Thaarun23/Jerboa_robot_simulation/Final_sw_files/leg_mechanism_1_leg.SLDASM

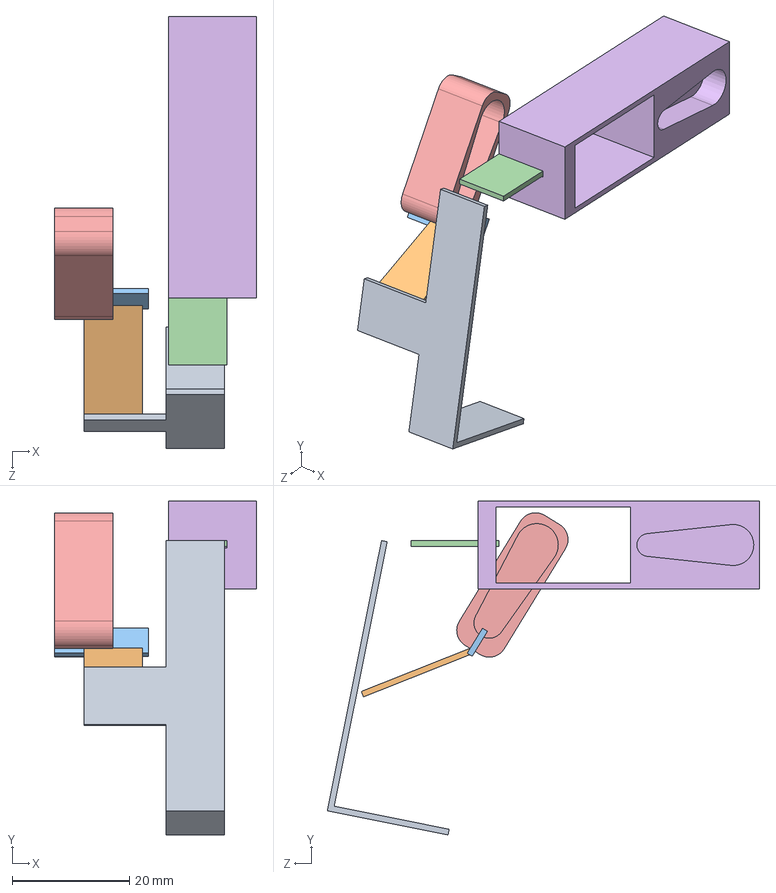
[picture p49: CAD file, 2025-03-19]
Final_sw_files/leg_mechanism_1_leg.SLDASM
34.5 x 57.0 x 73.7 mm
leg_1_ss
fitting_servo2
l1b_cut_2
l2l
l3l
l4f
