Thaarun23/Jerboa_robot_simulation/Final_sw_files/4bar_leg.SLDASM

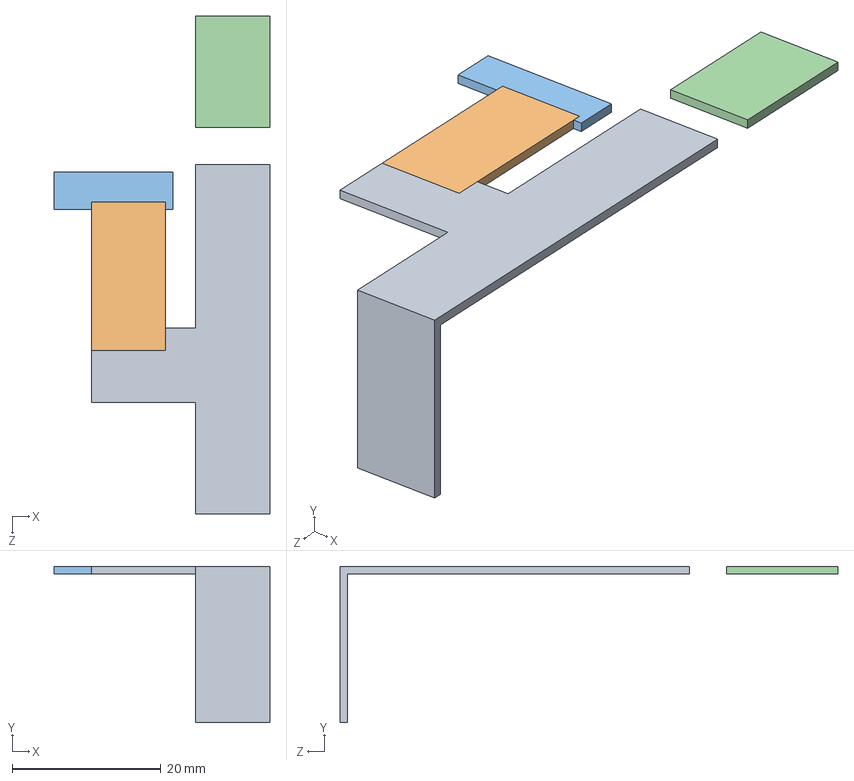
[picture p50: CAD file, 2025-03-19]
Final_sw_files/4bar_leg.SLDASM
29.0 x 21.0 x 67.0 mm
l1b_cut_2
l2l
l3l
l4f
