Thaarun23/Jerboa_robot_simulation/BODY CUT FILES FINAL/first_pass0.dxf

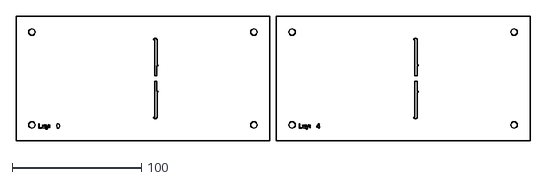
[picture p51: CAD file, 2025-03-19]
BODY CUT FILES FINAL/first_pass0.dxf
398.2 x 96.6
