Thaarun23/Jerboa_robot_simulation/LEG CUT FILES FINAL/final_cut2.dxf

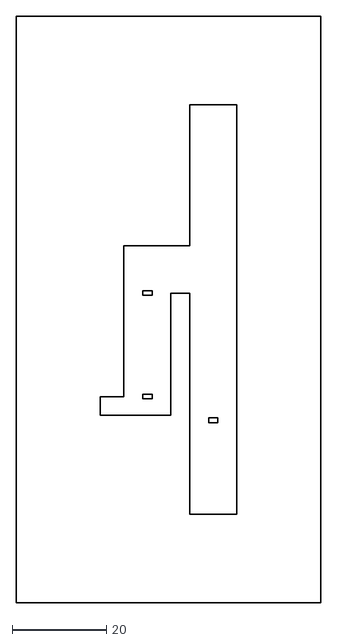
[picture p52: CAD file, 2025-03-19]
LEG CUT FILES FINAL/final_cut2.dxf
64.6 x 124.6
