Thaarun23/Jerboa_robot_simulation/leg_design_5.dxf

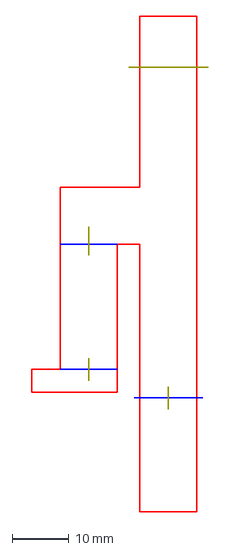
[picture p53: CAD file, 2025-03-19]
leg_design_5.dxf
31.0 x 87.0 mm
