Thaarun23/Jerboa_robot_simulation/BODY CUT FILES FINAL/first_pass2.dxf

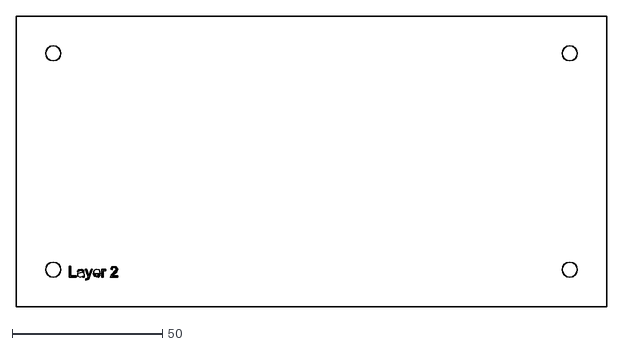
[picture p54: CAD file, 2025-03-19]
BODY CUT FILES FINAL/first_pass2.dxf
196.6 x 96.6
