Thaarun23/Jerboa_robot_simulation/body_tail_6.dxf

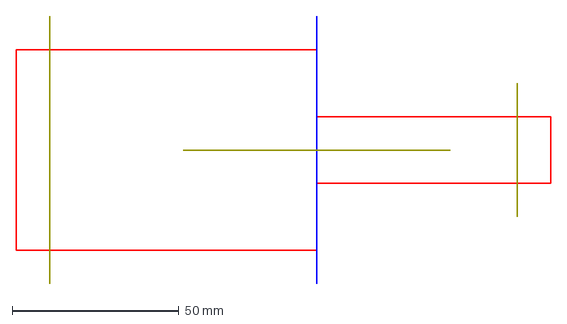
[picture p55: CAD file, 2025-03-19]
body_tail_6.dxf
160.0 x 80.0 mm
