Thaarun23/Jerboa_robot_simulation/LEG CUT FILES FINAL/first_pass2-2.dxf

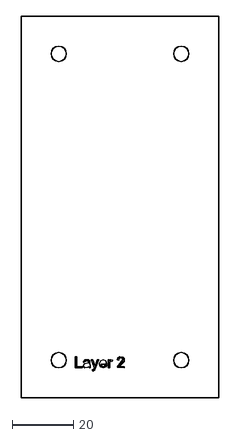
[picture p56: CAD file, 2025-03-19]
LEG CUT FILES FINAL/first_pass2-2.dxf
64.6 x 124.6
