Thaarun23/Jerboa_robot_simulation/BODY CUT FILES FINAL/first_pass1.dxf

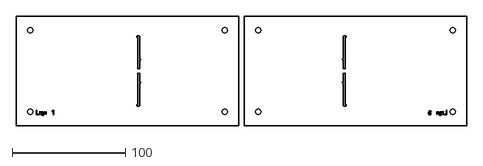
[picture p57: CAD file, 2025-03-19]
BODY CUT FILES FINAL/first_pass1.dxf
398.2 x 96.6
