Thaarun23/Jerboa_robot_simulation/Final_sw_files/l1b_cut.SLDPRT

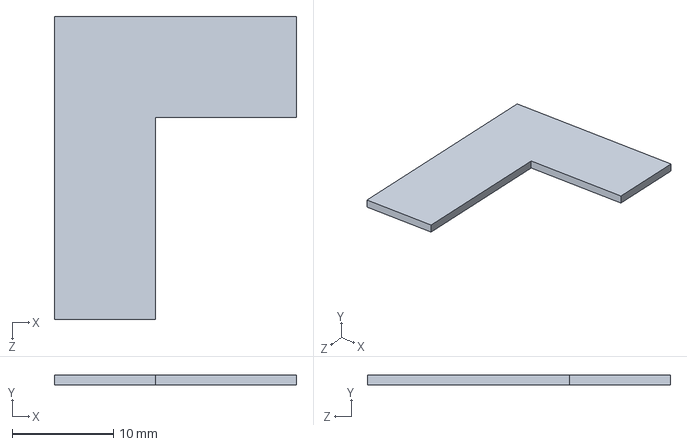
[picture p58: CAD file, 2025-03-19]
Final_sw_files/l1b_cut.SLDPRT
24.0 x 1.00 x 30.0 mm
