Thaarun23/Jerboa_robot_simulation/LEG CUT FILES FINAL/first_pass2.dxf

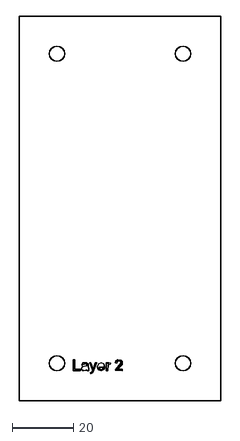
[picture p59: CAD file, 2025-03-19]
LEG CUT FILES FINAL/first_pass2.dxf
65.9 x 125.9
