Thaarun23/Jerboa_robot_simulation/BODY CUT FILES FINAL/first_pass2-2.dxf

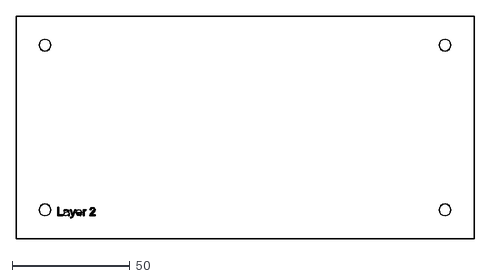
[picture p60: CAD file, 2025-03-19]
BODY CUT FILES FINAL/first_pass2-2.dxf
194.6 x 94.6
