Thaarun23/Jerboa_robot_simulation/Final_sw_files/l3l.SLDPRT

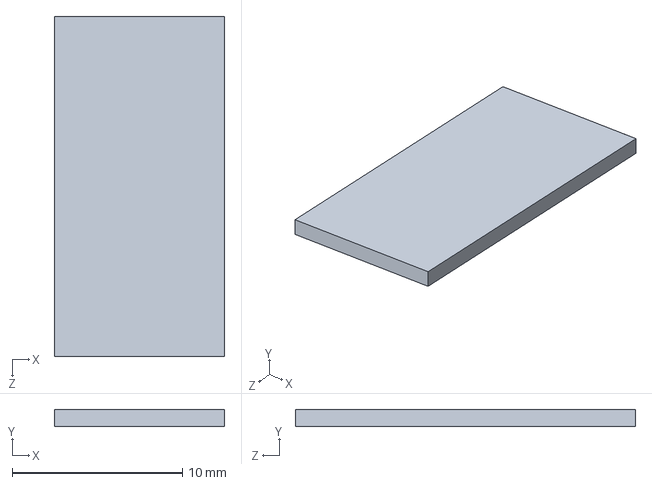
[picture p61: CAD file, 2025-03-19]
Final_sw_files/l3l.SLDPRT
10.0 x 1.00 x 20.0 mm
