Thaarun23/Jerboa_robot_simulation/BODY CUT FILES FINAL/final_cut2.dxf

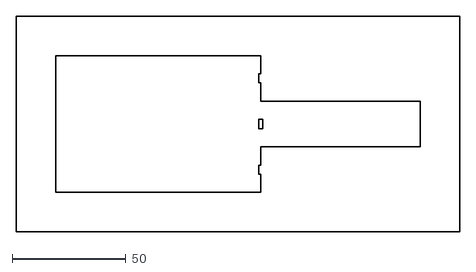
[picture p63: CAD file, 2025-03-19]
BODY CUT FILES FINAL/final_cut2.dxf
194.6 x 94.6
