Thaarun23/Jerboa_robot_simulation/LEG CUT FILES FINAL/final_cut.dxf

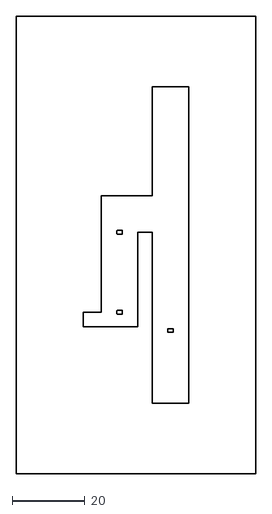
[picture p64: CAD file, 2025-03-19]
LEG CUT FILES FINAL/final_cut.dxf
65.9 x 125.9
