Thaarun23/Jerboa_robot_simulation/BODY CUT FILES FINAL/first_pass2-0.dxf

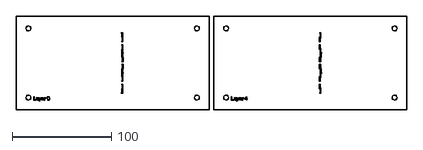
[picture p65: CAD file, 2025-03-19]
BODY CUT FILES FINAL/first_pass2-0.dxf
394.2 x 94.6
