Thaarun23/Jerboa_robot_simulation/Final_sw_files/l1b_cut_2.SLDPRT

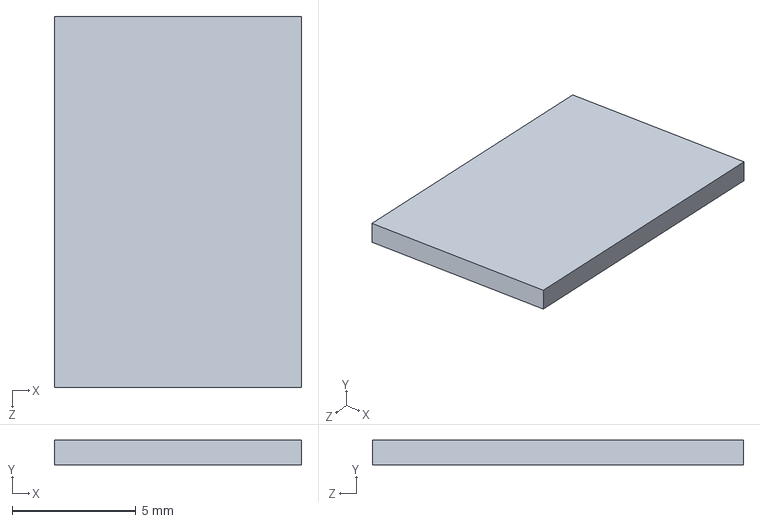
[picture p66: CAD file, 2025-03-19]
Final_sw_files/l1b_cut_2.SLDPRT
10.0 x 1.00 x 15.0 mm
