Thaarun23/Jerboa_robot_simulation/LEG CUT FILES FINAL/first_pass0.dxf

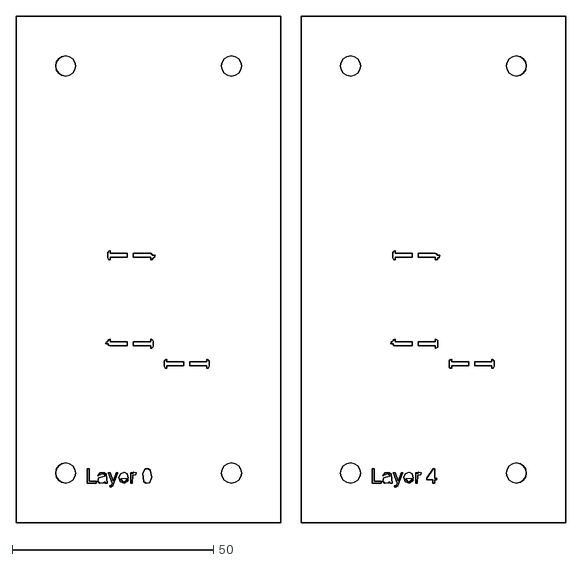
[picture p67: CAD file, 2025-03-19]
LEG CUT FILES FINAL/first_pass0.dxf
136.7 x 125.9
