Thaarun23/Jerboa_robot_simulation/BODY CUT FILES FINAL/final_cut.dxf

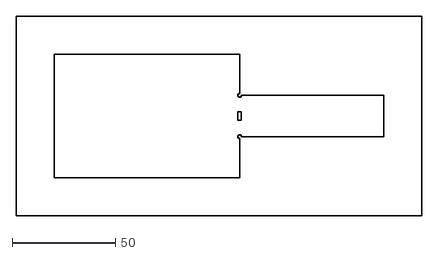
[picture p68: CAD file, 2025-03-19]
BODY CUT FILES FINAL/final_cut.dxf
196.6 x 96.6
