Thaarun23/Jerboa_robot_simulation/Final_sw_files/leg_1_ss.SLDPRT

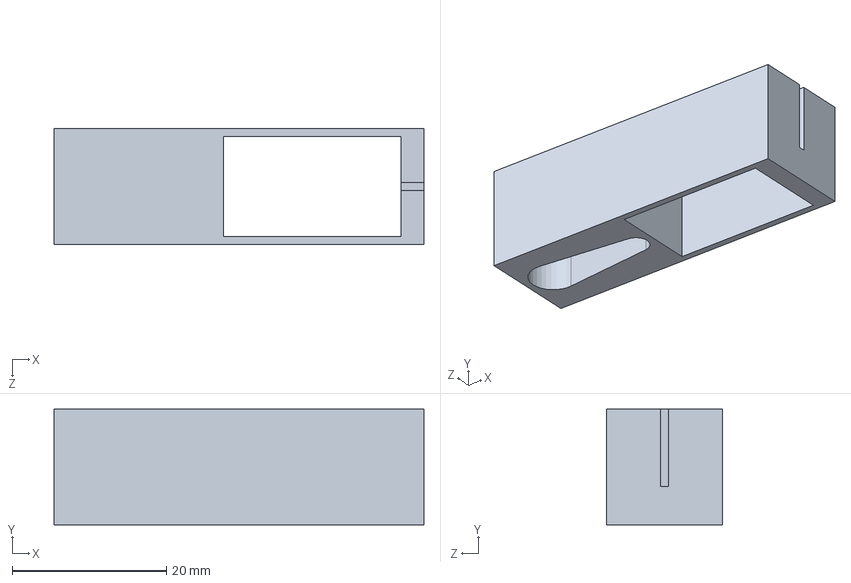
[picture p69: CAD file, 2025-03-19]
Final_sw_files/leg_1_ss.SLDPRT
48.0 x 15.0 x 15.0 mm
