Thaarun23/Jerboa_robot_simulation/LEG CUT FILES FINAL/first_pass2-0.dxf

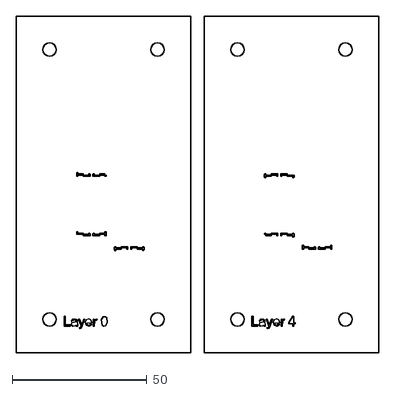
[picture p70: CAD file, 2025-03-19]
LEG CUT FILES FINAL/first_pass2-0.dxf
134.2 x 124.6
