Thaarun23/Jerboa_robot_simulation/Final_sw_files/l2l.SLDPRT

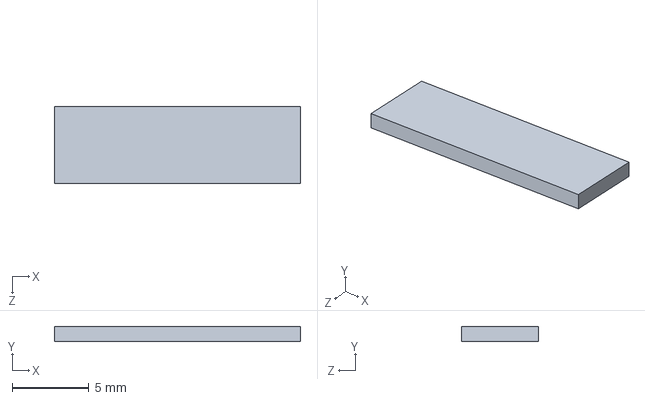
[picture p72: CAD file, 2025-03-19]
Final_sw_files/l2l.SLDPRT
16.0 x 1.00 x 5.00 mm
