Thaarun23/Jerboa_robot_simulation/Final_sw_files/base_link.SLDPRT

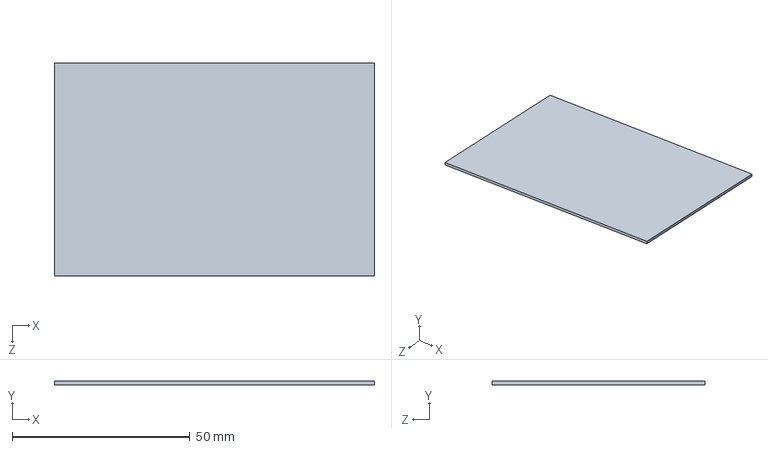
[picture p73: CAD file, 2025-03-19]
Final_sw_files/base_link.SLDPRT
90.0 x 1.00 x 60.0 mm
