Thaarun23/Jerboa_robot_simulation/LEG CUT FILES FINAL/first_pass1.dxf

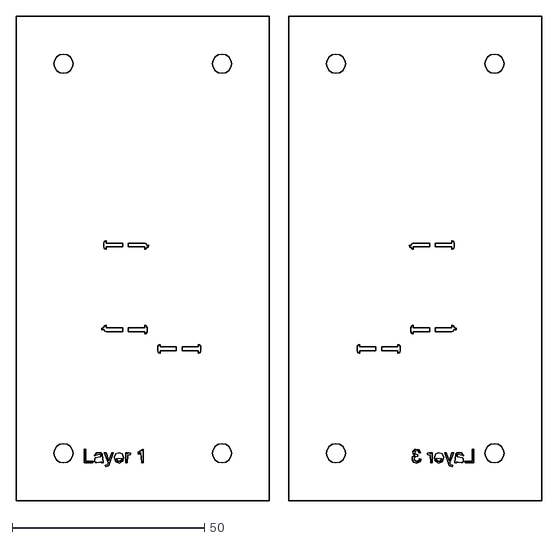
[picture p74: CAD file, 2025-03-19]
LEG CUT FILES FINAL/first_pass1.dxf
136.7 x 125.9
