Thaarun23/Jerboa_robot_simulation/Final_sw_files/fitting_servo2.SLDPRT

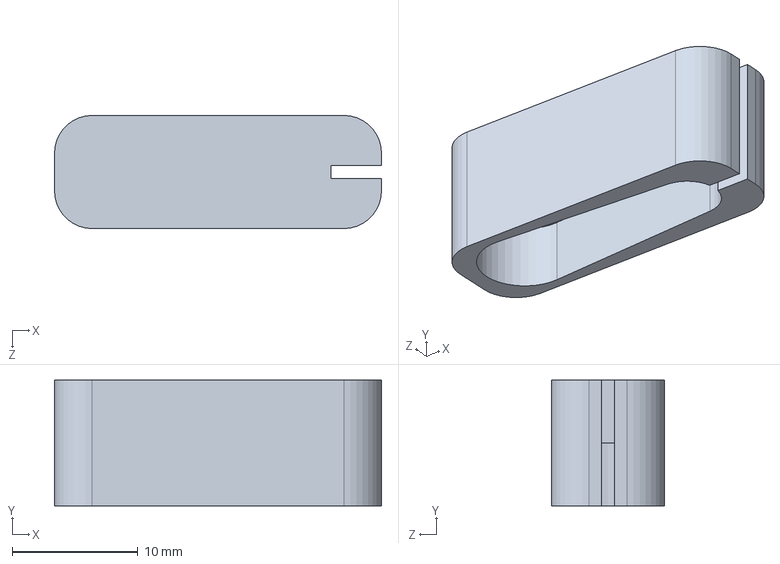
[picture p75: CAD file, 2025-03-19]
Final_sw_files/fitting_servo2.SLDPRT
26.0 x 10.0 x 9.00 mm
