Thaarun23/Jerboa_robot_simulation/Final_sw_files/l1b.SLDPRT

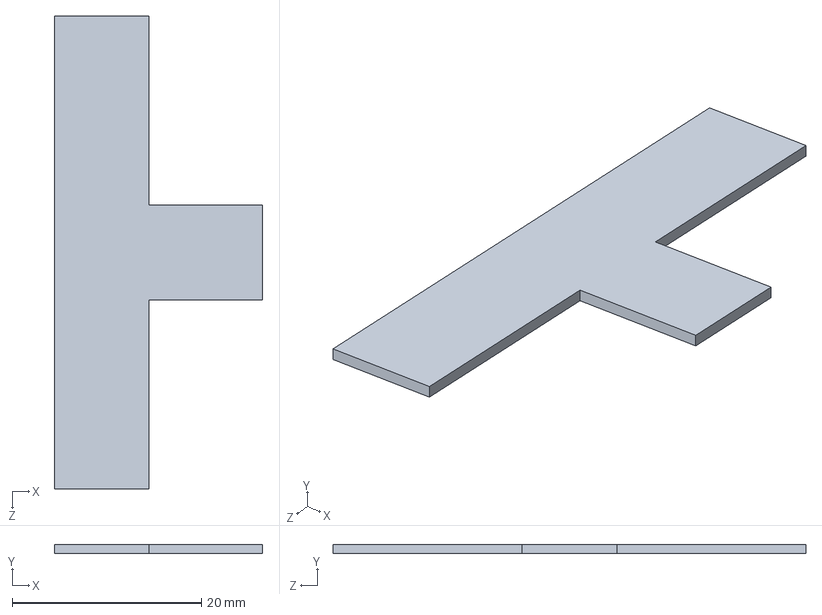
[picture p76: CAD file, 2025-03-19]
Final_sw_files/l1b.SLDPRT
22.0 x 1.00 x 50.0 mm
