Thaarun23/Jerboa_robot_simulation/Final_sw_files/l4f.SLDPRT

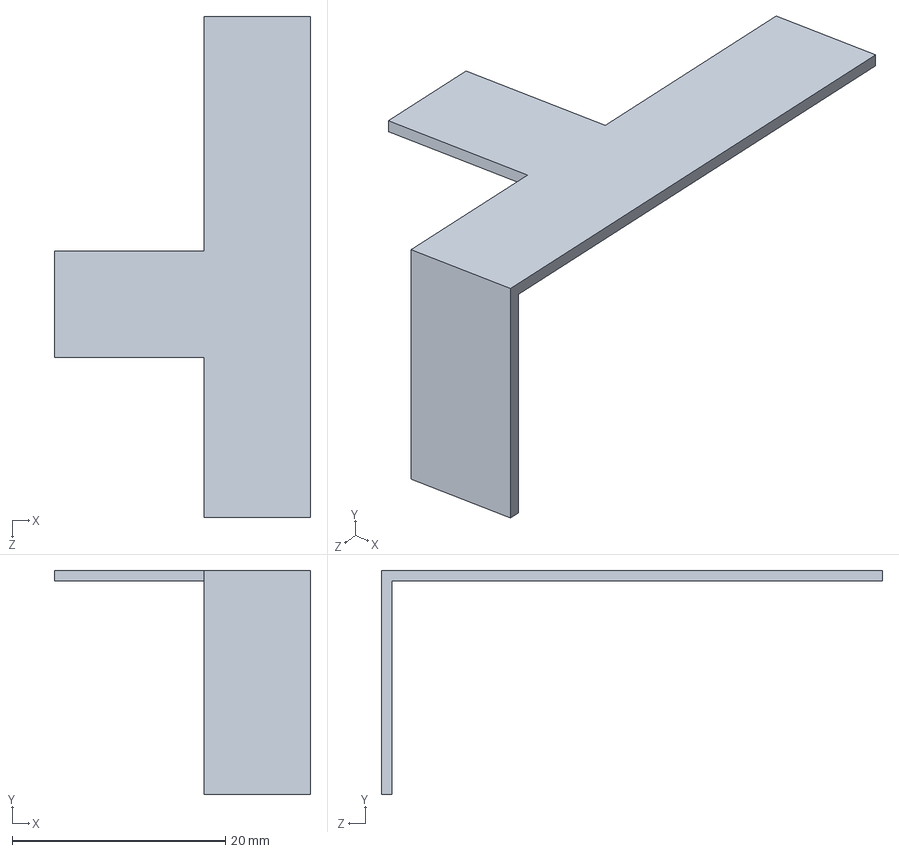
[picture p77: CAD file, 2025-03-19]
Final_sw_files/l4f.SLDPRT
24.0 x 21.0 x 47.0 mm
