Thaarun23/Jerboa_robot_simulation/Final_sw_files/leg_mechanism.SLDASM

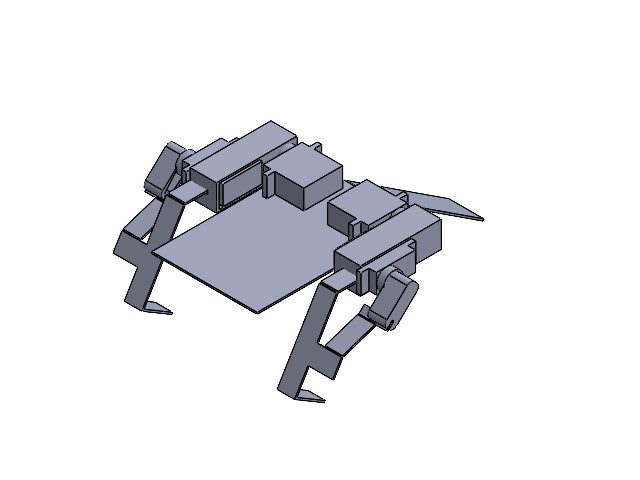
[picture p78: CAD file, 2025-03-19]
Final_sw_files/leg_mechanism.SLDASM
leg_1_ss x 2
base_link
servo x 2
servo_fixture x 4
Mirrorservo x 2
l4f
l3l x 2
fitting_servo2 x 2
l1b_cut_2 x 2
l2l x 2
Mirrorl4f
tail
