Thaarun23/Jerboa_robot_simulation/Final_sw_files/body_tail.SLDASM

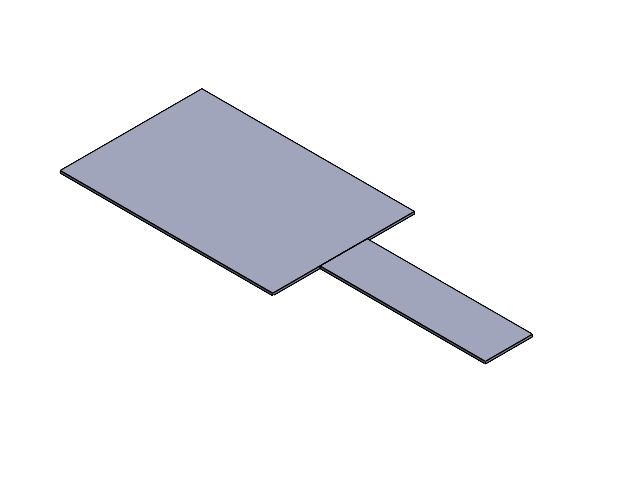
[picture p79: CAD file, 2025-03-19]
Final_sw_files/body_tail.SLDASM
base_link
tail
