Thaarun23/Jerboa_robot_simulation/(list of files, cad)

Other CAD files:
Final_sw_files/Assem1.SLDASM
Final_sw_files/jump_bot_skhematic_kinematics.SLDASM
